PyCubed-Mini/avionics-cameraboard/cameraboard.kicad_pcb

## KiCad design cameraboard.kicad_pcb (2023-06-20)

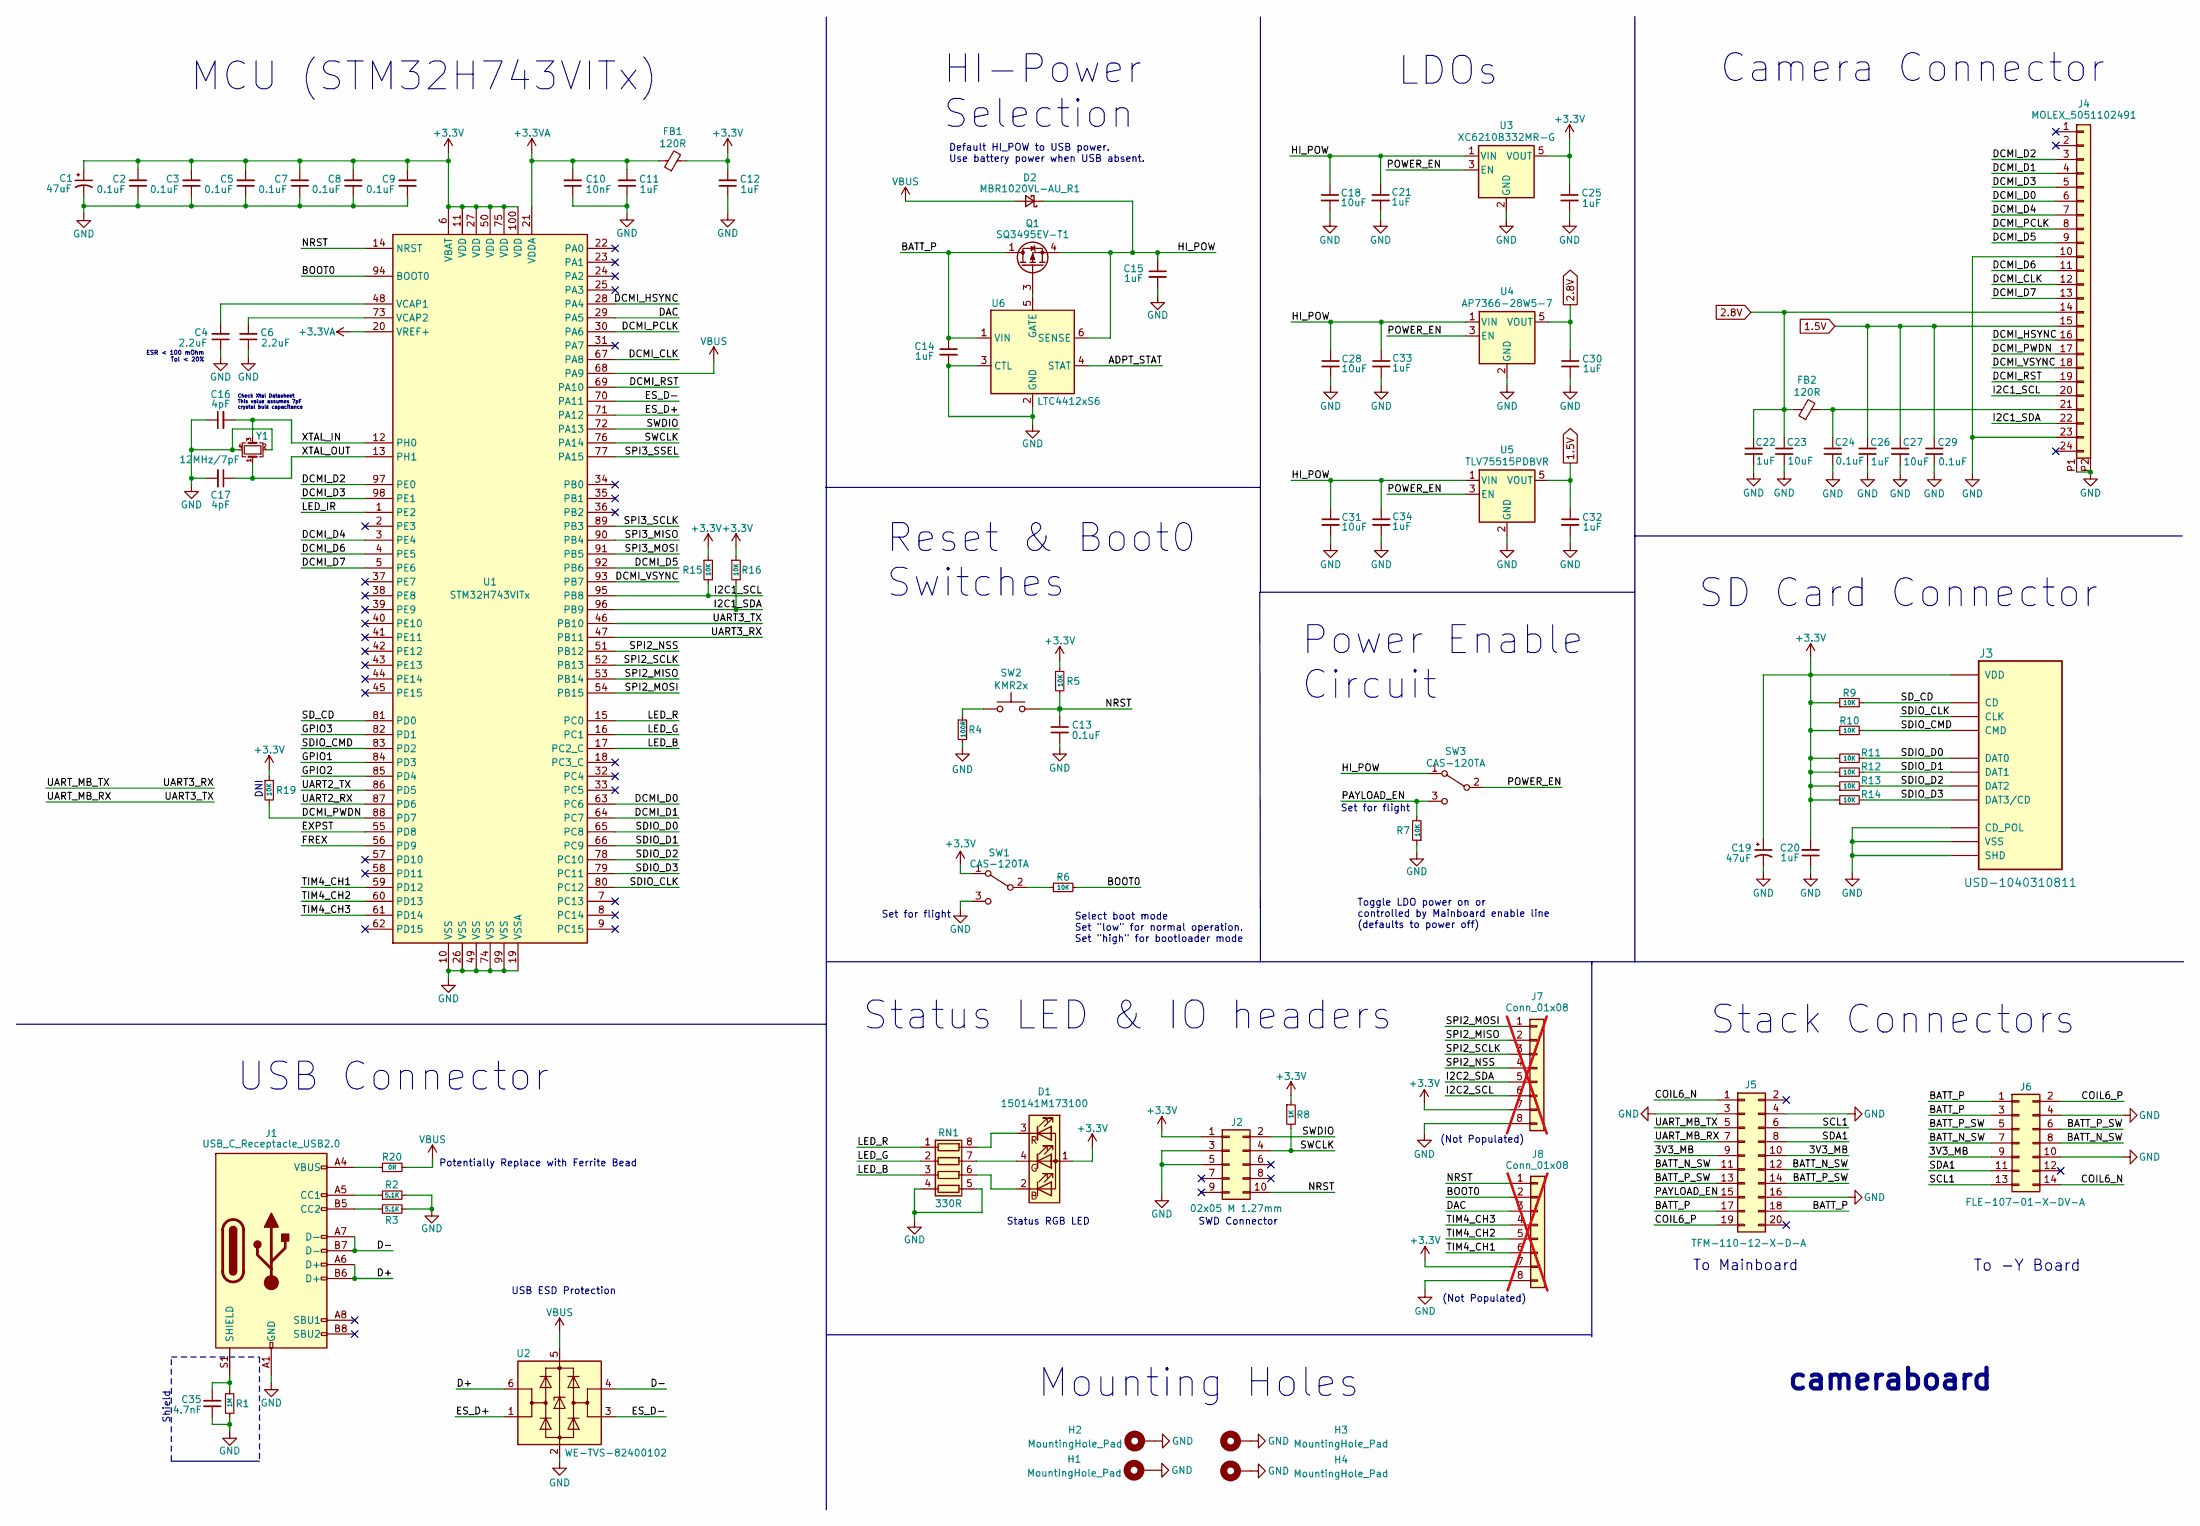
[picture p1: schematic cameraboard.kicad_sch, PyCubed Mini]

Parts:
C1, C19: 47uF; CP_EIA-2012-12_Kemet-R
C2, C3, C5, C7, C8, C9, C13, C24, C29: 0.1uF; C_0603_1608Metric
C4, C6: 2.2uF; C_0603_1608Metric
C10: 10nF; C_0603_1608Metric
C11, C12, C14, C15, C20, C21, C22, C25, C26, C30, C32, C33, C34: 1uF; C_0603_1608Metric
C16, C17: 4pF; C_0603_1608Metric
C18, C23, C27, C28, C31: 10uF; C_0603_1608Metric
C35: 4.7nF; C_0603_1608Metric
D1: 150141M173100; LED_RGB_Wuerth-PLCC4_3.2x2.8mm_150141M173100
D2: MBR1020VL-AU_R1; D_SOD-123F
FB1, FB2: 120R; L_0603_1608Metric
H1, H2, H3, H4: MountingHole_Pad; MountingHole
J1: USB_C_Receptacle_USB2.0; USB_C_Receptacle_HRO_TYPE-C-31-M-12
J2: 02x05 M 1.27mm; PinHeader_2x05_P1.27mm_Vertical_SMD
J3: USD-1040310811; microSD_HC_Molex_104031-0811
J4: MOLEX_5051102491
J5: TFM-110-12-X-D-A; SAMTEC_TFM-110-12-X-D-A
J6: FLE-107-01-X-DV-A; SAMTEC_FLE-107-01-X-DV-A
J7, J8: Conn_01x08; PinHeader_1x08_P2.54mm_Vertical; not fitted
Q1: SQ3495EV-T1; SOT-23-6
R1: 1M; R_0603_1608Metric
R2, R3: 5.1K; R_0603_1608Metric
R4: 100R; R_0603_1608Metric
R5, R6, R7, R9, R10, R11, R12, R13, R14, R15, R16, R19: 10K; R_0603_1608Metric
R8: 1K; R_0603_1608Metric
R20: 0R; R_0603_1608Metric
RN1: 330R; R_Array_Concave_4x0603
SW1, SW3: CAS-120TA
SW2: KMR2x; BTN_KMR2
U1: STM32H743VITx; LQFP-100_14x14mm_P0.5mm
U2: WE-TVS-82400102; SOT-23-6
U3: XC6210B332MR-G; SOT-23-5
U4: AP7366-28W5-7; SOT-23-5
U5: TLV75515PDBVR; SOT-23-5
U6: LTC4412xS6; TSOT-23-6
Y1: 12MHz/7pF; Crystal_SMD_2520-4Pin_2.5x2.0mm

Connections:
1.5V: C26.1, C27.1, C29.1, C32.1, J4.15, U5.5 (VOUT)
2.8V: C22.1, C23.1, C30.1, FB2.1, J4.14, U4.5 (VOUT)
+3.3V: C1.1, C2.2, C3.2, C5.2, C7.2, C8.2, C9.2, C12.2, C19.1, C20.2, C25.1, D1.1 (A), FB1.2, J2.1, J3.4 (VDD), J7.7, J8.7, R5.1, R8.1, R9.1, R10.1, R11.1, R12.1, R13.1, R14.1, R15.1, R16.1, R19.1, SW1.1 (A), U1.6 (VBAT), U1.11 (VDD), U1.27 (VDD), U1.50 (VDD), U1.75 (VDD), U1.100 (VDD), U3.5 (VOUT)
+3.3VA: C10.2, C11.2, FB1.1, U1.20 (VREF+), U1.21 (VDDA)
/3V3_MB: J5.9, J5.10, J6.9
/ADPT_STAT: U6.4 (STAT)
/BATT_N_SW: J5.11, J5.12, J6.7, J6.8
/BATT_P: C14.1, J5.17, J5.18, J6.1, J6.3, Q1.1 (D), Q1.2 (D), Q1.5 (D), Q1.6 (D), U6.1 (VIN)
/BATT_P_SW: J5.13, J5.14, J6.5, J6.6
/BOOT0: J8.2, R6.2, U1.94 (BOOT0)
/COIL6_N: J5.1, J6.14
/COIL6_P: J5.19, J6.2
/D+: J1.A6 (D+), J1.B6 (D+), U2.6 (I/O1)
/D-: J1.A7 (D-), J1.B7 (D-), U2.4 (I/O2)
/DAC: J8.3, U1.29 (PA5)
/DCMI_CLK: J4.12, U1.67 (PA8)
/DCMI_D0: J4.6, U1.63 (PC6)
/DCMI_D1: J4.4, U1.64 (PC7)
/DCMI_D2: J4.3, U1.97 (PE0)
/DCMI_D3: J4.5, U1.98 (PE1)
/DCMI_D4: J4.7, U1.3 (PE4)
/DCMI_D5: J4.9, U1.92 (PB6)
/DCMI_D6: J4.11, U1.4 (PE5)
/DCMI_D7: J4.13, U1.5 (PE6)
/DCMI_HSYNC: J4.16, U1.28 (PA4)
/DCMI_PCLK: J4.8, U1.30 (PA6)
/DCMI_PWDN: J4.17, R19.2, U1.88 (PD7)
/DCMI_RST: J4.19, U1.69 (PA10)
/DCMI_VSYNC: J4.18, U1.93 (PB7)
/ES_D+: U1.71 (PA12), U2.1 (I/O1)
/ES_D-: U1.70 (PA11), U2.3 (I/O2)
/EXPST: U1.55 (PD8)
/FREX: U1.56 (PD9)
/GPIO1: U1.84 (PD3)
/GPIO2: U1.85 (PD4)
/GPIO3: U1.82 (PD1)
/HI_POW: C15.1, C18.1, C21.1, C28.1, C31.1, C33.1, C34.1, D2.1 (K), Q1.4 (S), SW3.1 (A), U3.1 (VIN), U4.1 (VIN), U5.1 (VIN), U6.6 (SENSE)
/I2C1_SCL: J4.20, R15.2, U1.95 (PB8)
/I2C1_SDA: J4.22, R16.2, U1.96 (PB9)
/LED_B: RN1.3 (R3.1), U1.17 (PC2_C)
/LED_G: RN1.2 (R2.1), U1.16 (PC1)
/LED_IR: U1.1 (PE2)
/LED_R: RN1.1 (R1.1), U1.15 (PC0)
/NRST: C13.1, J2.10, J8.1, R5.2, SW2.2, U1.14 (NRST)
/PAYLOAD_EN: J5.15, R7.2, SW3.3 (C)
/POWER_EN: SW3.2 (B), U3.3 (EN), U4.3 (EN), U5.3 (EN)
/SCL1: J5.6, J6.13
/SDA1: J5.8, J6.11
/SDIO_CLK: J3.5 (CLK), U1.80 (PC12)
/SDIO_CMD: J3.3 (CMD), R10.2, U1.83 (PD2)
/SDIO_D0: J3.7 (DAT0), R11.2, U1.65 (PC8)
/SDIO_D1: J3.8 (DAT1), R12.2, U1.66 (PC9)
/SDIO_D2: J3.1 (DAT2), R13.2, U1.78 (PC10)
/SDIO_D3: J3.2 (DAT3/CD), R14.2, U1.79 (PC11)
/SD_CD: J3.10 (CD), R9.2, U1.81 (PD0)
/SPI2_MISO: J7.2, U1.53 (PB14)
/SPI2_MOSI: J7.1, U1.54 (PB15)
/SPI2_NSS: J7.4, U1.51 (PB12)
/SPI2_SCLK: J7.3, U1.52 (PB13)
/SPI3_MISO: U1.90 (PB4)
/SPI3_MOSI: U1.91 (PB5)
/SPI3_SCLK: U1.89 (PB3)
/SPI3_SSEL: U1.77 (PA15)
/SWCLK: J2.4, R8.2, U1.76 (PA14)
/SWDIO: J2.2, U1.72 (PA13)
/TIM4_CH1: J8.6, U1.59 (PD12)
/TIM4_CH2: J8.5, U1.60 (PD13)
/TIM4_CH3: J8.4, U1.61 (PD14)
/UART2_RX: U1.87 (PD6)
/UART2_TX: U1.86 (PD5)
/UART3_RX: J5.5, U1.47 (PB11)
/UART3_TX: J5.7, U1.46 (PB10)
/XTAL_IN: C16.2, U1.12 (PH0), Y1.3
/XTAL_OUT: C17.1, U1.13 (PH1), Y1.1
GND: C1.2, C2.1, C3.1, C4.1, C5.1, C6.1, C7.1, C8.1, C9.1, C10.1, C11.1, C12.1, C13.2, C14.2, C15.2, C16.1, C17.2, C18.2, C19.2, C20.1, C21.2, C22.2, C23.2, C24.2, C25.2, C26.2, C27.2, C28.2, C29.2, C30.2, C31.2, C32.2, C33.2, C34.2, C35.1, H1.1, H2.1, H3.1, H4.1, J1.A1 (GND), J1.A12 (GND), J1.B1 (GND), J1.B12 (GND), J2.3, J2.5, J3.6 (VSS), J3.9 (CD_POL), J3.11 (SHD), J4.10, J4.23, J4.P1, J4.P2, J5.3, J5.4, J5.16, J6.4, J6.10, J7.8, J8.8, R1.2, R2.2, R3.2, R4.2, R7.1, RN1.4 (R4.1), RN1.5 (R4.2), SW1.3 (C), U1.10 (VSS), U1.19 (VSSA), U1.26 (VSS), U1.49 (VSS), U1.74 (VSS), U1.99 (VSS), U2.2 (GND), U3.2 (GND), U4.2 (GND), U5.2 (GND), U6.2 (GND), U6.3 (CTL), Y1.2, Y1.4
unnamed: D1.2 (BK), RN1.6 (R3.2)
unnamed: D1.4 (GK), RN1.7 (R2.2)
unnamed: D1.3 (RK), RN1.8 (R1.2)
unnamed: J1.A5 (CC1), R2.1
unnamed: J1.B5 (CC2), R3.1
unnamed: C35.2, J1.S1 (SHIELD), R1.1
unnamed: J1.A4 (VBUS), J1.A9 (VBUS), J1.B4 (VBUS), J1.B9 (VBUS), R20.1
unnamed: C24.1, FB2.2, J4.21
unnamed: Q1.3 (G), U6.5 (GATE)
unnamed: R4.1, SW2.1
unnamed: R6.1, SW1.2 (B)
unnamed: C4.2, U1.48 (VCAP1)
unnamed: C6.2, U1.73 (VCAP2)
VBUS: D2.2 (A), R20.2, U1.68 (PA9), U2.5 (VBUS)

Notes on the sheet:
Mounting Holes
Set for flight
cameraboard
SD Card Connector
(Not Populated)
Check Xtal Datasheet This value assumes 7pF crystal bulk capacitance
Power Enable Circuit
HI-Power Selection
To Mainboard
To -Y Board
Potentially Replace with Ferrite Bead
Status LED & IO headers
DNI
MCU (STM32H743VITx)
Status RGB LED
SWD Connector
Reset & Boot0 Switches
Stack Connectors
Toggle LDO power on or controlled by Mainboard enable line (defaults to power off)
Shield
LDOs
Select boot mode Set "low" for normal operation. Set "high" for bootloader mode
USB Connector
Camera Connector
ESR < 100 mOhm Tol < 20%
Default HI_POW to USB power. Use battery power when USB absent.
USB ESD Protection

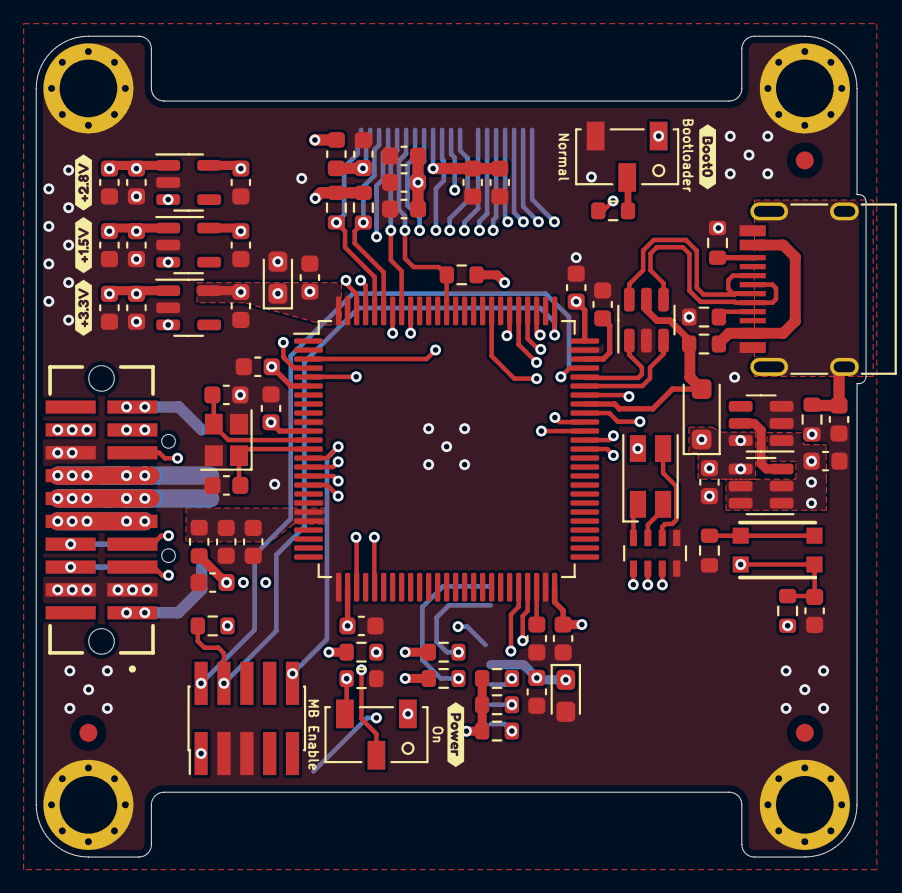
[picture p2: board cameraboard.kicad_pcb from above]

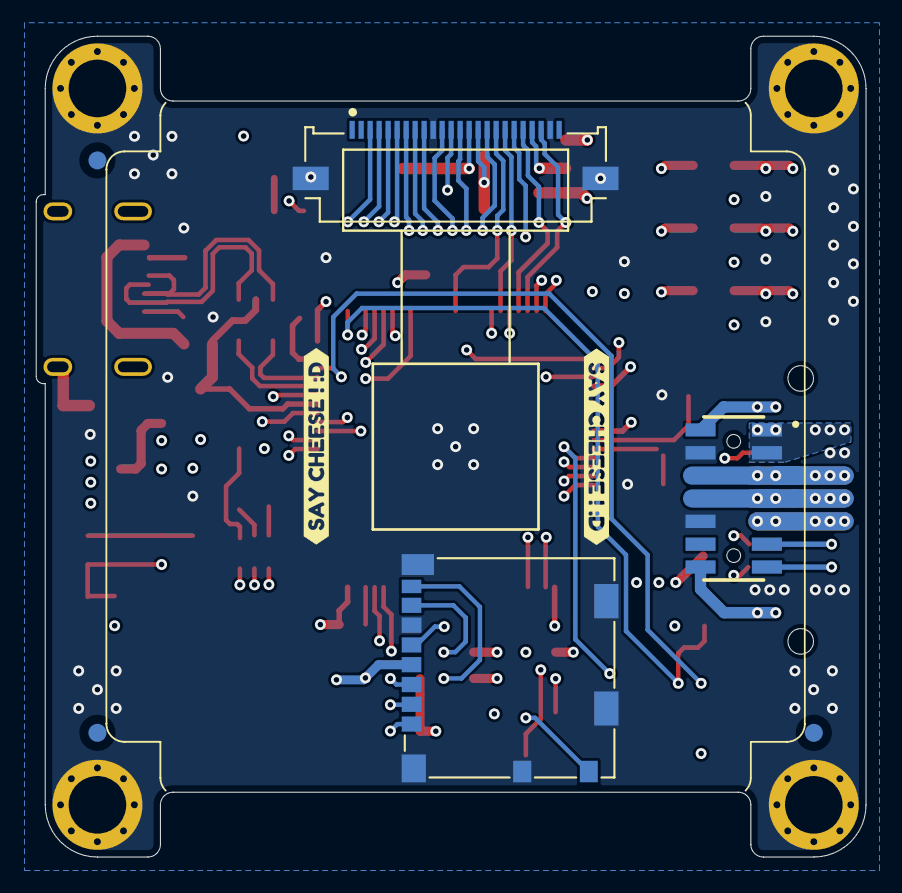
[picture p3: board cameraboard.kicad_pcb from below]

Board: 4 copper layers, 46.1 x 45.6 mm, 87 parts (5 on the bottom side), 68 nets.

Other parts of the board:
Ref**: Val**; pycubed_mini_half
kibuzzard-63E3EA3E: G***; kibuzzard-63E3EA3E
kibuzzard-63E3EAF3: G***; kibuzzard-63E3EAF3
kibuzzard-63E3EBF1: G***; kibuzzard-63E3EBF1
kibuzzard-63E3EC1C: G***; kibuzzard-63E3EC1C
kibuzzard-63E3EC09: G***; kibuzzard-63E3EC09
kibuzzard-63E3ED57, kibuzzard-63E3ED57#2: G***; kibuzzard-63E3ED57
