PyCubed-Mini/avionics-cameraboard/(threads)

Thread 6 (2023-03-26):

Remove 22 Ohm resistors on USB lines

NeilKhera, 2023-03-26:

NeilKhera, 2023-04-27:
Fixed in Rev B3/02

Closed 2023-04-27.
