PyCubed-Mini/avionics-cameraboard/(commit log)

2022-03-24 File upload
    [cameraboard.kicad_pcb, cameraboard.kicad_sch]
2022-03-24 camera step file
    [nicla_vision.step]
2022-03-24 black gloss
    [nicla_vision.step]
2022-03-24 Updated PCB 3d model
    [cameraboard.kicad_pcb]
2022-03-25 Moved nicla model to kicad_libs, exported pcb model
    [cameraboard.kicad_pcb, cameraboard.kicad_sch, nicla_vision.step]
2022-03-28 Added Mounting Holes on main and camera boards
    [cameraboard.kicad_pcb]
2022-05-31 Changed board shape and rewired
    [cameraboard.kicad_pcb, cameraboard.kicad_sch]
2022-06-02 Schematic fixes and re-routing
    [cameraboard.kicad_pcb, cameraboard.kicad_sch]
2022-06-03 Moved stuff into place
    [cameraboard.kicad_pcb, cameraboard.kicad_sch]
2022-06-08 stack connectors changes
    [cameraboard.kicad_pcb, cameraboard.kicad_sch]
2022-06-09 Moved connectors as recommended
    [cameraboard.kicad_pcb]
2022-06-09 Rename VBUS to VUSB and export files
    [cameraboard.kicad_pcb, cameraboard.kicad_sch]
2022-06-09 Added Logo, version number and date
    [cameraboard.kicad_pcb]
2022-06-10 Exported Gerbers
    [cameraboard.kicad_pcb]
2022-06-27 Moved Camera slightly, added bus protection
    [cameraboard.kicad_pcb, cameraboard.kicad_sch]
2022-06-29 moved camera connector
    [cameraboard.kicad_pcb]
2022-06-29 moved connector
2022-06-29 Re-routed for new connector location
    [cameraboard.kicad_pcb]
2022-06-29 Re-check board and re-export model
    [cameraboard.kicad_pcb]
2022-06-30 new outline of camera board
    [cameraboard-outline.dxf]
2022-07-01 New cameraboard outline
    [cameraboard.kicad_pcb]
2022-07-06 nikla -> nicla
    [cameraboard.kicad_sch]
2022-07-06 Export New Gerbers
    [cameraboard.kicad_pcb, cameraboard.kicad_sch]
2022-08-24 Custom spun board updates
    [cameraboard-outline.dxf, cameraboard.kicad_pcb, cameraboard.kicad_sch]
2022-12-23 Change Stash
    [cameraboard.kicad_sch]
2023-02-08 Finished Routing
    [-Y-keepout.dxf, cameraboard.kicad_pcb, cameraboard.kicad_sch]
2023-02-09 Export 3D Model
    [cameraboard.kicad_pcb]
2023-02-19 Simplified Enable Circuit
    [-Y-keepout.dxf, cameraboard-outline.dxf, cameraboard.kicad_pcb, cameraboard.kicad_sch]
2023-02-22 Stash before changes
    [cameraboard.kicad_pcb, cameraboard.kicad_sch]
2023-02-25 Moved SWD header and power switch to prevent mechanical interference
    [cameraboard.kicad_pcb]
2023-02-25 Pulled latest kicad-libs
2023-02-26 Removed gerbers from repo
2023-04-27 Rev B3/02 updates
    [cameraboard.kicad_pcb, cameraboard.kicad_sch]
2023-06-18 Rewired UART lines to mainboard
    [cameraboard.kicad_pcb, cameraboard.kicad_sch]
2023-06-19 Moved SD card connector to allow removal with rails installed
    [cameraboard.kicad_pcb, cameraboard.kicad_sch]
2023-06-20 PCB cleanup
    [cameraboard.kicad_pcb]
